aldalt/Barbell-Level-Detector/README.md

# Barbell-Level-Detector
An embedded device that measures barbell orientation using an MPU-6050 IMU and STM32 microcontroller and provides visual feedback when the bar is not level enough.

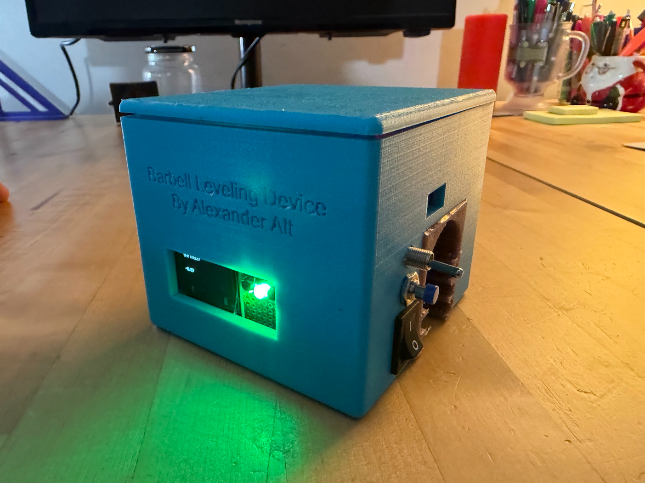
[picture p1: Photos/FrontPhoto.png]

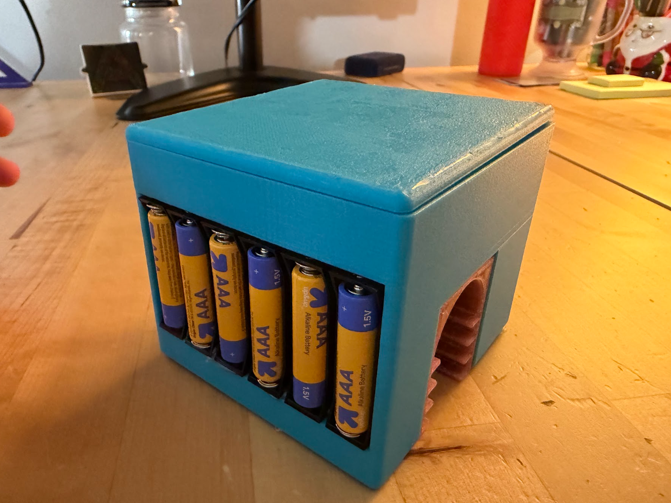
[picture p2: Photos/BackPhoto.png]
BackPhoto


## FEATURES
- Real-time barbell orientation measurement
- MPU-6050 IMU with accelerometer and gyroscope
- Madgwick sensor fusion algorithm
- OLED orientation display
- Push-button calibration
- STM32-based embedded firmware written in C

## DEMONSTRATION
### VIDEO
The demo video can be found here:
https://drive.google.com/file/d/12szGBzlijnexQQqcazzed6xgYGelAo9s/view?usp=sharing 

## HARDWARE
|COMPONENT|MODEL|PURPOSE|
|:----|:----|:----|
|Microcontroller|STM32-F446RE Development Board|Main Processing Unit|
|IMU|Adafruit MPU-6050 Breakout Board|Accelerometer and Gyroscope Measurements|
|Display|Adafruit 0.96" OLED Graphic Display|Displaying Status, Orientation and Level Information|
|Power Source|6xAAA Battery Pack|Power for Device|
|Button|Momentary Switch|Initiates Calibration|

For this project, a STM32 development board was used to ensure simple hardware configuration, as this was intended to serve as an introduction to the STM32. The STM32-F446RE board was used because it has plenty of I/O, including support for I2C, SPI, PWM, GPIO and more, and has plenty of memory and onboard flash storage for experimentation. 

The MPU-6050 IMU and the display module are connected to the STM32 board using I2C. Two separate I2C channels are used, for simplicity of wiring and straightforward debugging.

For the calibration button, a simple momentary switch was wired up to the STM32 using a GPIO input pin.

To power the device, a bank of 6 AAA batteries were wired in series, to provide 9V DC power to the device. Since the STM32 can accept a range of 7V-12V on its VIN pin, 9V provides sufficient power to fall within this range, while not being unnecessarily heavy. AAA batteries are compact, cheap and easy to swap, making them a reasonable choice.  

## SOFTWARE

Development Software Used: STM32CubeIDE, STM32CubeMX, STM32 HAL Library

Programming Language Used: C

Interfaces Used: I2C, Timers, PWM, GPIO

Algorithms Used: Madgwick Sensor Fusion Algorithm, IMU Calibration Algorithm

The software for this project is entirely written in C. There are 5 different source code files that I created, each with their own respective header file:
- The display.c file contains the necessary functions for displaying text on the SSD1306 OLED, such as creating the display matrix array, updating the display, clearing the display, etc.
- The fonts.c file contains the data for the onscreen font, where each letter is represented by a 5x7 grid. Each letter is listed as 5 hexadecimal numbers representing its 5 columns.
- The imu.c file contains the functions for the IMU, including initializing, calibrating, receiving data, etc.
- The madgwick.c file contains the procedure for the Madgwick sensor fusion algorithm.
- The main.c file is what brings all of these source files together, and contains the main operating script for the device.
Within the STM32CUBEIDE, there were other C files that were generated automatically to help the device function, but those were not included here since I did not write or modify them, and they are largely for background tasks such as initializing the STM32. 

## SYSTEM ARCHITECTURE

### BLOCK DIAGRAM
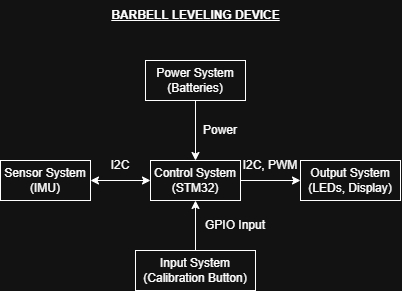
[picture p3: Photos/BlockDiagram.png]
BlockDiagram


The device consists of 5 main systems that interact with each other. The control system, which consists of the STM32, is the brain of the device. The power system, made up of the battery pack, powers the control system, which distributes power to the other systems. The control system sends and receives signals over the I2C protocol with the sensor system, consisting of the accelerometer and gyroscope in the IMU. The output system consists of a display, which receives its intput signals over I2C, and the LEDs, which are powered over a PWM pin. Finally, the input system consists of the calibration button, which is connected to the device via a GPIO input pin.

## HOW IT WORKS

### HOW THE IMU GATHERS DATA
The inertial measurement unit (IMU) measures acceleration and gyroscope (rotational velocity) data, storing each of these measured values in an 8-bit register. To retrieve this data, the STM32 sends a request over the I2C bus to the IMU's unique hardware address (0x68). In response, the IMU streams all 14 8-bit data measurements consecutively over the I2C bus in one burst, in a 14-byte buffer that is read in by the STM32. 

The single output stream from the IMU can then be separated into the x, y and z commponents of the acceleration and gyroscope, as well as the temperature (although the temperature is not used here). This data is then passed into the Madgwick algorithm to be filtered. 

### HOW THE MADGWICK ALGORITHM WORKS
The Madgwick Algorithm, invented by Sebastian Madgwick, is a sensor fusion technique that involves representing an object's orientation as a quaternion, which is a 4-dimensional math vector. One part represents scalar magnitude of an object's rotation, where the other three parts represent the vector components of the onject's angle of rotation. The gyroscope and accelerometer data are processed in distinct ways that are fused together at the end using gradient descent.

To process the gyroscope data, the algorithm integrates the incoming angular velocity over the time that passes between readings, accurately representing the change in the device's velocity. However, this data suffers from excessive noise and compouding error in the gyroscope's orientation, so the result is merely an approximation.

To get a more accurate result, a gradient function is used to atler the quaternion to reduce the error. First, quaternion multiplication is used to multiply the velocity estimate vector by the acccelerometer by its quaternion conjugate and the reference vector of Earth's gravity ([0,0,0,1]). This gives us a calculated gravity vector in the sensor's coordinate frame. We then subtract the acceleration vector from the accelerometer from this calculated gravity vector, giving us an objective function representing the error in the gyroscope's orientation estimate. 

To determine which way the gyroscope reading should be altered to reduce its error, a gradient function is then calculated, whigh is a matrix of first order partial derivatives of each component of the objective function relative to each component of the quaternion. The transpose of this matrix can then be multiplied by the objective error function to determine the direction of greatest ascent of error.

To eliminate this error, the algorithm takes the calculated direction of greatest ascent and reverses it, giving the direction of greatest descent of error. This reversed vector is then normalized to ensure a consistent step size. This step represents a single iteration of gradient descent, which tells the algorithm exactly how to tweak the four components of the quaternion to align the gyroscope's drift with the stable reference of physical gravity.

Every sensor sample, the algorithm calculates one gradient descent, which is then scaled by a tuneable parameter called the filter gain, represented by beta. This determines how much the algorithm trusts the accelerometer relative to the gyroscope. 

Finally, the algorithm subtracts this scaled gradient from the angular velocity estimate calculated with the gyroscope data. This gives an mprovced rate of change in the quaternion with elss error. This is then integrated over the time step and added to the previous orientation, to calculate the new position. From each of these resulting position quaternions, the pitch, roll, and yaw can be calculated using standardized formulas to get real world orientation data. 

### HOW "LEVEL" IS DEFINED
The threshold for the barbell being "level" is adjustable in the software. For testing purposes, I allowed 5 degrees of barbell tilt either way, as this allows for a mostly level barbell while also allowing for a small amount of error. Within fitness communities online, it is said that a barbell should have no more than 3 degrees of tilt, so it may be worth adjusting to this threshold in the software. 

## CALIBRATION

### CALIBRATION PROCEDURE

The device features a momentary switch (button) on the side to "calibrate" it, or to set what is defined as "level". After the device initializes the IMU, it prompts the user to press the button, to set the "level" position while the barbell is located on the rack. When the button is pressed, the IMU takes 400 samples of the x, y and z components of the gyroscope and acceleration measurements, and averages them to get a baseline for each value. This is necessary because the Madgwick algorithm involves integrating change in the values over time, so there must be some "initial" value for the first calculation.

### WHY CALIBRATION IS NECESSARY

There are several reasons why a calibration function is necessary, instead of just setting some specific values for the initial acceleration and gyroscope values. Firstly, there is no guarantee that the barbell is actually straight. If the barbell is worn or has a lot of weight on it, and the device is not perfectly in the center, it might not start perfectly level. Secondly, if the device is being used on a grip other than a standard straight barbell, such as a curl bar, the device might not actually be level with the ground when the barbell is, meaning that some adjustment would be necessary. Lastly, it is not guaranteed (and likely not possible) that the IMU is mounted perfectly level within the enclosure, meaning that if a set value were used for the intial measurements, they could vary from what they would actually be if the device was level.

## WIRING/PINOUT

### SCHEMATIC
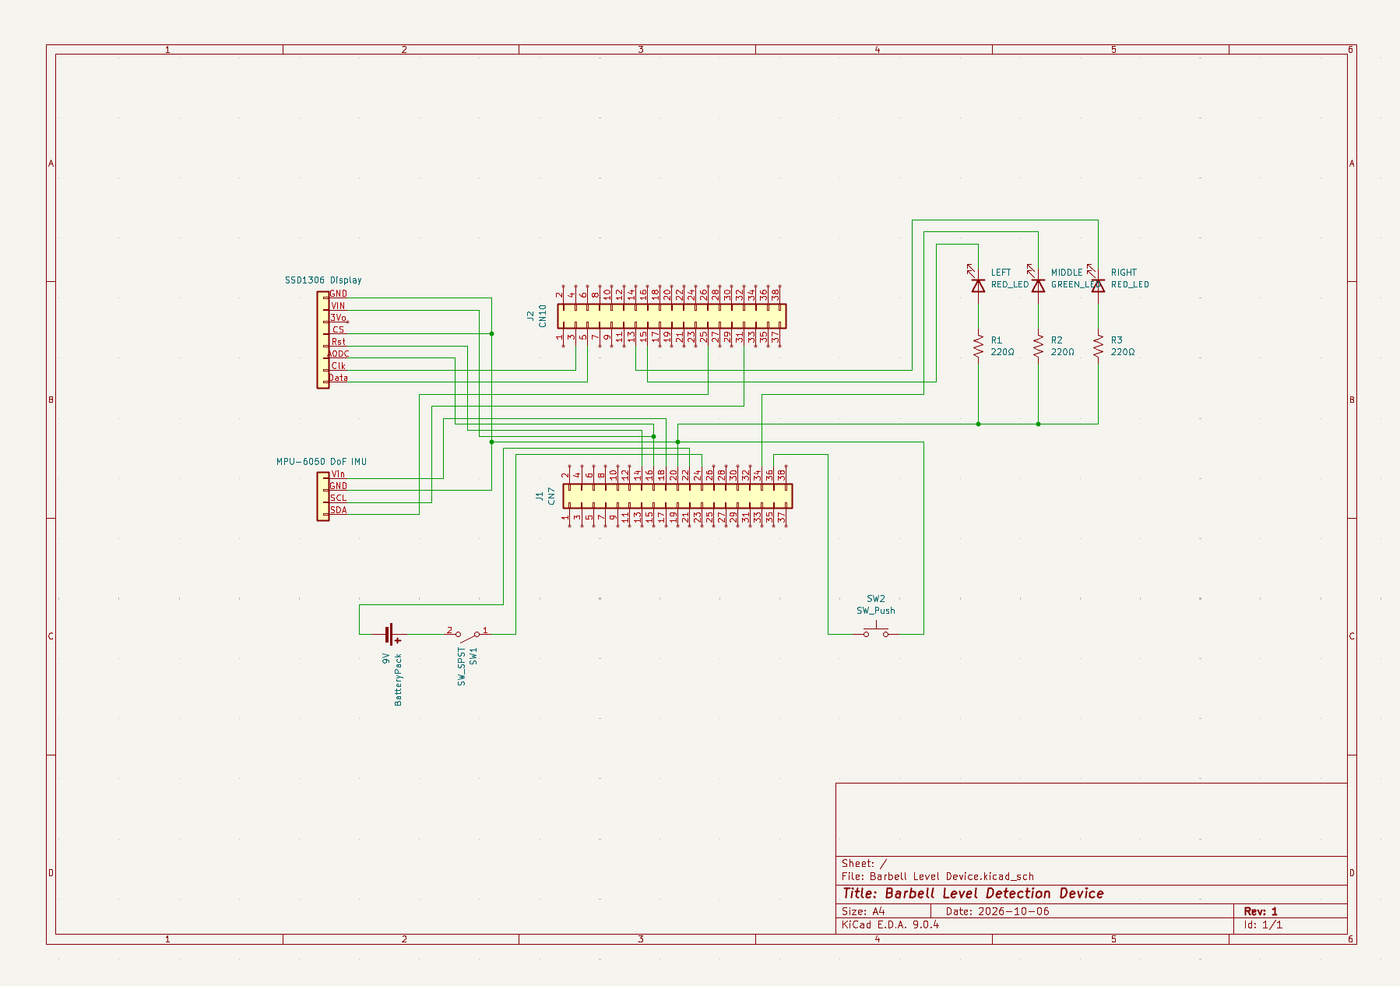
[picture p4: Photos/Schematic.png]
Schematic


### PINOUT

|ST Morpho Pin|Protocol|Function|
|---|---|---|
|CN7 Pin 14|Reset|Display Reset|
|CN7 Pin 16|Power|3V Power Out|
|CN7 Pin 18|Power|5V Power Out|
|CN7 Pin 20|Power|Ground|
|CN7 Pin 22|Power|Ground|
|CN7 Pin 24|Power|9V Power In|
|CN7 Pin 34|PWM|Middle LED|
|CN7 Pin 36|GPIO|Calibration Button|
|CN10 Pin 3|I2C|OLED Display Data|
|CN10 Pin 5|I2C|OLED Display Clock|
|CN10 Pin 13|PWM|Right LED|
|CN10 Pin 15|PWM|Left LED|
|CN10 Pin 25|I2C|IMU Data|
|CN10 Pin 31|I2C|IMU Clock|

** It should be noted that the device also has a switch connected to the power jumper that switches the STM32 between USB and VIN power (the silver switch connected with green blue and purple wires in the photo). This switch is omitted from the schematic and pinout because it does not control the function of the device, beyond switching the power source. 

### PHOTO
This is the device's electronics, assembled outside of the enclosure. 
Electronics

The display, IMU, and LEDs are mounted to a protoyping board, to hold them in place relative to each other, and ensure that all connections stay as they should. The 6 AAA batteries are wired in series on another protoyping board, creating one solid power supply for the device. Jumper wires are used to connect the soldered components on the board to the STM32. 

This is the electronics assembled inside the enclosure.
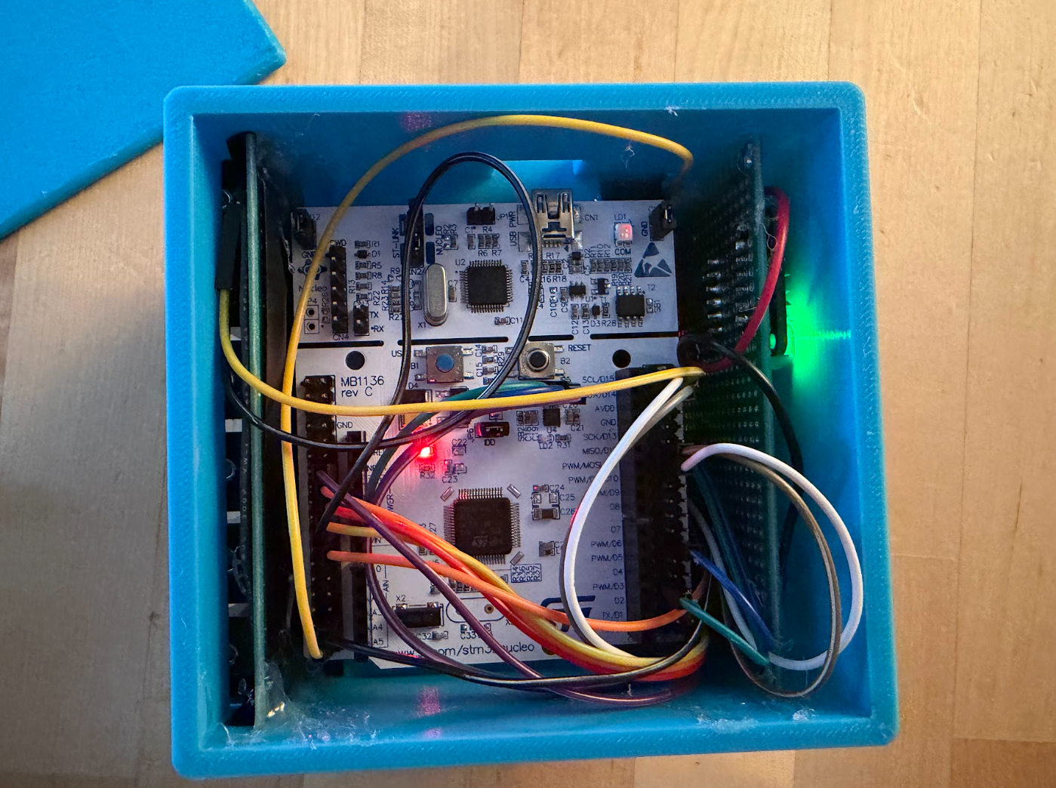
[picture p5: Photos/ElectronicsAssembled.png]
Electronics_assembled


## 3D PRINTED ENCLOSURE
To contain the device's electronics and give it a clean look, an enclosure was designed in CAD and 3D printed. The enclosure was printed from PLA filament, as it is affordable and easy to work with, making it ideal for prototyping. However, to allow the device to grip onto barbells of varying sizes, a TPU grip sleeve was used for the grip in the center. The TPU sleeve has little ribs that stick out on the inside, which deform when the device is pressed onto a barbell, ensuring a tight grip. The two pieces were printed seperately and then glued together for a secure fit.
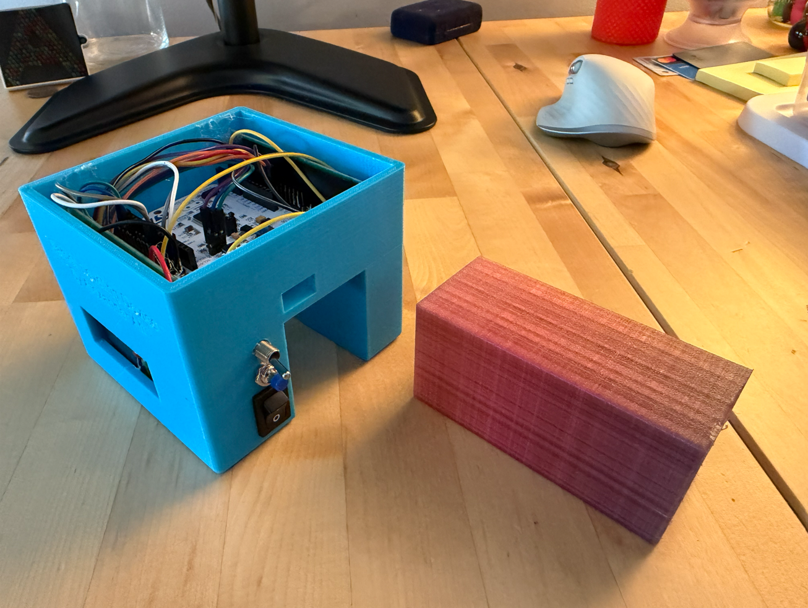
[picture p6: Photos/GripSleeve.png]
Grip


The final enclosure was the second iteration. The initial design had both the STM32 and the display/imu board located on one side of the barbell and the battery board located on the other, making the device rather bulky. The second iteration moved the STM32 to on top of the barbell, allowing the device to be much more commpact, while also allowing for easier access to the connectors on the STM32 while the device is fully assembled. 
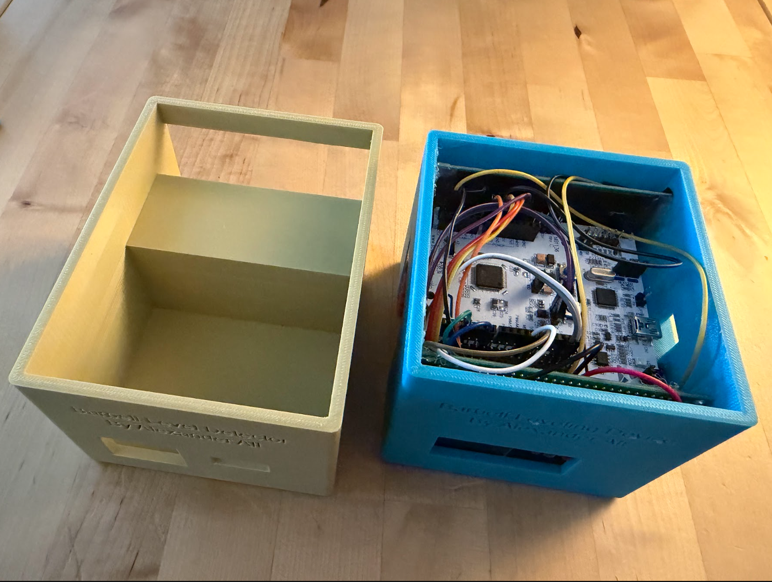
[picture p7: Photos/TwoEnclosures.png]
Two Versions


## POTENTIAL FUTURE IMPROVEMENTS

There are several features that could be added to a second version of the project to improve practicality, including:
- A custom PCB
- A rechargable lithium-ion battery pack with USB-C charging
- Adjustable thresholds for "level"
- The ability to log data
- A slightly bigger screen for easier visibility

The biggest change, which I thought of after I had already assembled everything, would be to assemble the display/imu PCB differently. In its current state, the pins on the display and IMU are connected back to the STM32 using jumper wires that were soldered to the board. However, a smarter way to to it would've been to solder some rows of pin headers to the backs of the prototybe board to connect to the Arduino headers, and then connect all of the display and IMU pins to those. This way, the PCB could just plug into the STM32 as a daughterboard that connects right to the arduino headers, rather than having to run a bunch of wires.

## AUTHOR
Alexander Alt

Computer Engineering Student

Purdue University

West Lafayette, IN
