aldalt/Barbell-Level-Detector/CAD Files/Barbell Level Grip v1.stl

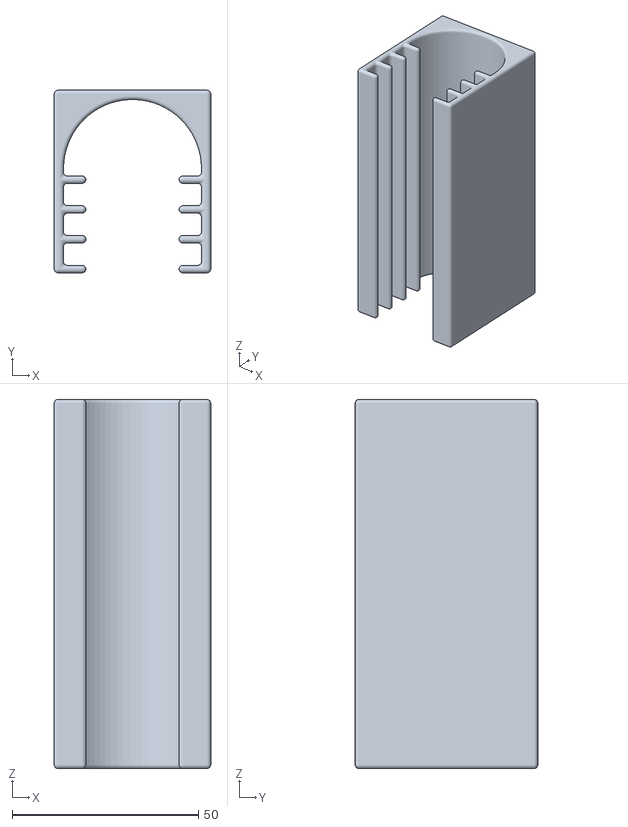
[picture p8: CAD file, 2026-10-21]
CAD Files/Barbell Level Grip v1.stl
42.0 x 49.0 x 99.0
