aldalt/Barbell-Level-Detector/CAD Files/Barbell Level Enclosure V3.stl

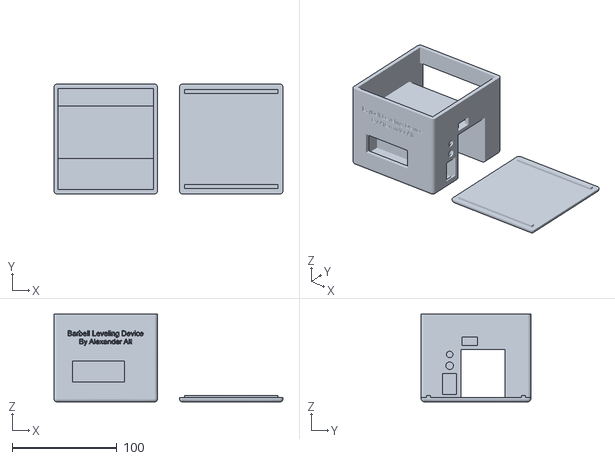
[picture p9: CAD file, 2026-10-21]
CAD Files/Barbell Level Enclosure V3.stl
219.0 x 105.0 x 84.0
