aldalt/Barbell-Level-Detector/Code/Source Code/main.c

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
/* Includes ------------------------------------------------------------------*/
#include "main.h"

I2C_HandleTypeDef hi2c1;
I2C_HandleTypeDef hi2c2;
TIM_HandleTypeDef htim3;
UART_HandleTypeDef huart2;

void SystemClock_Config(void);
static void MX_GPIO_Init(void);
static void MX_USART2_UART_Init(void);
static void MX_I2C1_Init(void);
static void MX_I2C2_Init(void);
static void MX_TIM3_Init(void);
/**
  * @brief  The application entry point.
  * @retval int
  */
int main(void)
{

  /* MCU Configuration--------------------------------------------------------*/
  /* Reset of all peripherals, Initializes the Flash interface and the Systick. */
  HAL_Init();

  /* Configure the system clock */
  SystemClock_Config();

  /* Initialize all configured peripherals */
  MX_GPIO_Init();
  MX_USART2_UART_Init();
  MX_I2C1_Init();
  MX_I2C2_Init();
  MX_TIM3_Init();
  /* USER CODE BEGIN 2 */

  HAL_TIM_PWM_Start(&htim3, TIM_CHANNEL_1);
  HAL_TIM_PWM_Start(&htim3, TIM_CHANNEL_2);
  HAL_TIM_PWM_Start(&htim3, TIM_CHANNEL_3);

  // 4. Manually cycle the physical hardware Reset pin to wake up the display controller
  HAL_GPIO_WritePin(GPIOA, GPIO_PIN_9, GPIO_PIN_RESET); // Drive RST low
  HAL_Delay(100);
  HAL_GPIO_WritePin(GPIOA, GPIO_PIN_9, GPIO_PIN_SET);   // Drive RST high
  HAL_Delay(100);

  // 5. Initialize the display parameters (Uses the fixed Adafruit init sequence)
  ScreenInit();

  // 6. Clear the graphic buffer and draw test text strings
  ClearScreen();
  StringWrite(0, 0, "SYSTEM STARTED", &Font_5x7, 1);
  StringWrite(0, 16, "STM32F446RE OK", &Font_5x7, 1);

  __HAL_RCC_I2C2_FORCE_RESET();
  HAL_Delay(20);
  __HAL_RCC_I2C2_RELEASE_RESET();


  /* Re-initialize I2C2 to apply clean registers */
  MX_I2C2_Init();
  HAL_Delay(200);
  ClearScreen();

    /* Pass the I2C2 handle address into IMU initialization code */
    if (InitializeImu(&hi2c2))
    {
    	StringWrite(0, 0, "INIT PASS", &Font_5x7, 1);
    	ScreenUpdate();
    	HAL_Delay(5000);
    	ClearScreen();
    	ScreenUpdate();
    }
    else // Initialization failed
    {
    	StringWrite(0, 0, "INIT FAIL", &Font_5x7, 1);
    	ScreenUpdate();
        while(1) {};
    }

    // Display Calibration Message
    StringWrite(0, 0, "PRESS BUTTON", &Font_5x7, 1);
    StringWrite(0, 16, "TO CALIBRATE", &Font_5x7, 1);
    StringWrite(0, 32, "THE SENSORS", &Font_5x7, 1);
    ScreenUpdate();

    // Wait until the button is pressed, then calibrate the IMU and clear the screen
    while(HAL_GPIO_ReadPin(BUTTON_GPIO_Port, BUTTON_Pin) == GPIO_PIN_SET) {};
    CalibrateImu();
    ClearScreen();
    StringWrite(0, 0, "BAR ANGLE:", &Font_5x7, 1);
    ScreenUpdate();

    // Initialize necessary variables
    ImuData my_data;
    uint32_t PrevTime = 0;
    uint32_t CurrTime = 0;
    float DeltaT = 0.0f;
    float Roll = 0.0f;

    // Beta is 0.1, trusts the gyroscope and accelerometer similarly
    // Higher beta means it trusts the accelerometer more, lower means it trusts the gyroscope more
    InitializeMadgwick(0.1);

    while (1)
    {
        if (GetImuData(&my_data))
        {
        	CurrTime = HAL_GetTick();
        	if (PrevTime == 0) PrevTime = CurrTime;

        	// Find Time Difference (in ms)
        	DeltaT = (float)(CurrTime - PrevTime) / 1000.0f;
        	PrevTime = CurrTime;

        	// Prevent divide by zero errors for faster than 1ms
        	if (DeltaT <= 0.0f) DeltaT = 0.001f;

        	// Run the Madgwick Filter
        	MadgwickFilter(my_data.gx, my_data.gy, my_data.gz, my_data.ax, my_data.ay, my_data.az, DeltaT);

        	// Find the roll from the Madgwick output
        	Roll = CalculateRoll();

        	// Create a buffer to write the roll to such that it can be displayed on the screen
        	char buffer[10];
			snprintf(buffer, sizeof(buffer), "%.2f", Roll);

            // Display the roll on the screen
        	StringWrite(0, 32, buffer, &Font_5x7, 1);
        	ScreenUpdate();

        	// Light up the LEDs to correspond with good/bad bar tilt
        	if (Roll > 3.0f) {
        		__HAL_TIM_SET_COMPARE(&htim3, TIM_CHANNEL_1, 1000);
        		__HAL_TIM_SET_COMPARE(&htim3, TIM_CHANNEL_2, 0);
        		__HAL_TIM_SET_COMPARE(&htim3, TIM_CHANNEL_3, 0);
        	}
        	else if (Roll < -3.0f) {
        		__HAL_TIM_SET_COMPARE(&htim3, TIM_CHANNEL_1, 0);
        		__HAL_TIM_SET_COMPARE(&htim3, TIM_CHANNEL_2, 1000);
        		__HAL_TIM_SET_COMPARE(&htim3, TIM_CHANNEL_3, 0);
        	}
        	else {
        		__HAL_TIM_SET_COMPARE(&htim3, TIM_CHANNEL_1, 0);
        		__HAL_TIM_SET_COMPARE(&htim3, TIM_CHANNEL_2, 0);
        		__HAL_TIM_SET_COMPARE(&htim3, TIM_CHANNEL_3, 1000);
        	}
        }
    }


  // 7. Push the local SRAM buffer across the I2C bus to the panel
  /* USER CODE END 2 */

  /* Infinite loop */
  /* USER CODE BEGIN WHILE */
  while (1)
  {
      // Fast-blink your onboard green LED to prove code is executing smoothly
      HAL_GPIO_TogglePin(GPIOA, GPIO_PIN_5);
      HAL_Delay(100);

    /* USER CODE END WHILE */

    /* USER CODE BEGIN 3 */
  }
  /* USER CODE END 3 */
}

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
