aldalt/Barbell-Level-Detector/(commit log)

2026-10-06 Added details about how the device works
2026-10-08 Added the pinout, schematic and photo of electronics
