aldalt/Barbell-Level-Detector/(notices)

Notices in the files:
Code/Header Files/main.h:
Copyright (c) 2026 STMicroelectronics.
All rights reserved.
This software is licensed under terms that can be found in the LICENSE file
